ngkz/E490-VRM-Fan-Controller/vrmfanctl_pcb/vrmfanctl_pcb.kicad_pcb

## KiCad design vrmfanctl_pcb/vrmfanctl_pcb.kicad_pcb (2019-10-17)

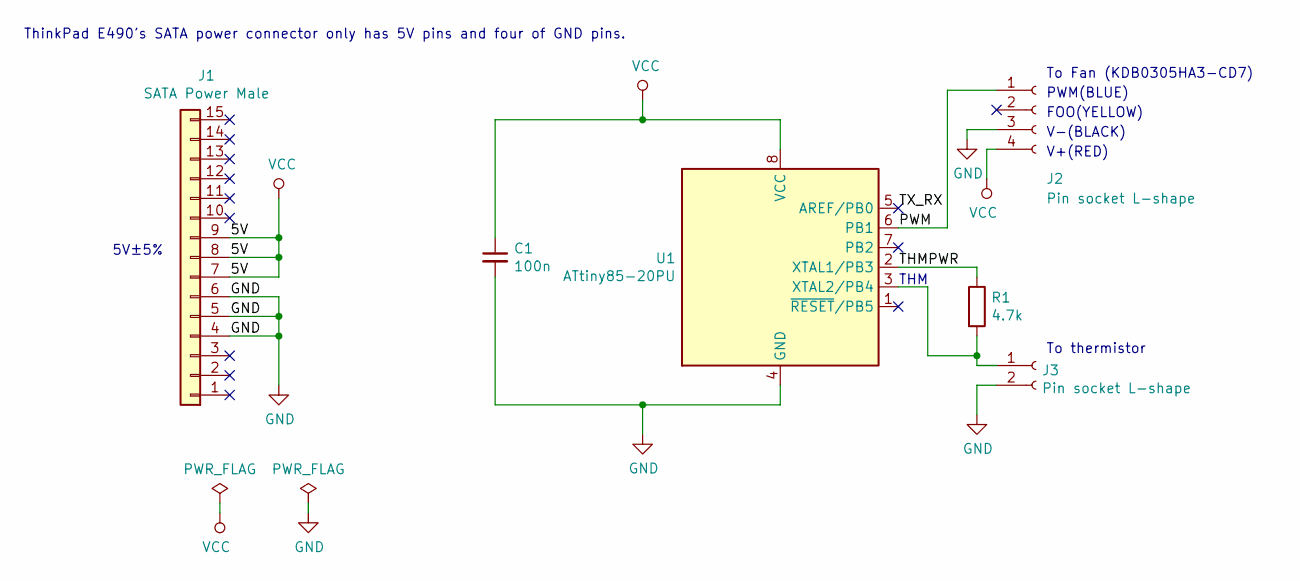
[picture p1: schematic vrmfanctl_pcb.sch]

Parts:
C1: 100n; C_Disc_D5.0mm_W2.5mm_P2.50mm
J1: SATA Power Male; SATA_Power_PCBEdge
J2: Pin socket L-shape; PinSocket_1x04_P2.54mm_Horizontal
J3: Pin socket L-shape; PinSocket_1x02_P2.54mm_Horizontal
R1: 4.7k; R_Axial_DIN0204_L3.6mm_D1.6mm_P5.08mm_Horizontal
U1: ATtiny85-20PU; DIP-8_W7.62mm

Connections:
/PWM: J2.1, U1.6 (PB1)
/THMPWR: R1.1, U1.2 (XTAL1/PB3)
/TX_RX: U1.5 (AREF/PB0)
GND: C1.2, J1.4, J1.5, J1.6, J2.3, J3.2, U1.4 (GND)
unnamed: J3.1, R1.2, U1.3 (XTAL2/PB4)
VCC: C1.1, J1.7, J1.8, J1.9, J2.4, U1.8 (VCC)

Notes on the sheet:
ThinkPad E490's SATA power connector only has 5V pins and four of GND pins.
PWM(BLUE)
FOO(YELLOW)
V-(BLACK)
V+(RED)
To Fan (KDB0305HA3-CD7)
5V±5%
To thermistor
THM

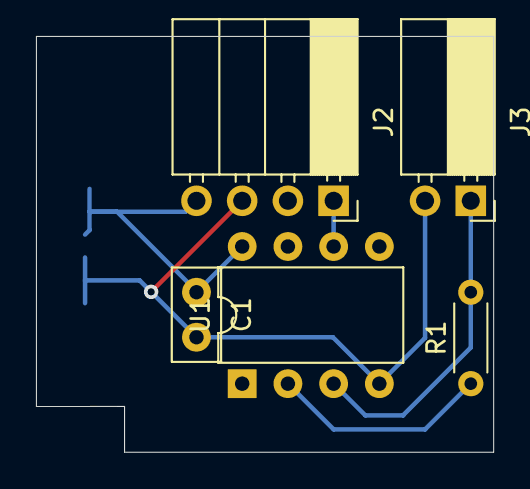
[picture p2: board vrmfanctl_pcb.kicad_pcb from above]

Board: 2 copper layers, 25.4 x 23.1 mm, 6 parts (1 on the bottom side), 5 nets.
