ngkz/E490-VRM-Fan-Controller/firmware/src/fan.c

/*
 *  ThinkPad E490 VRM Cooling Mod Controller Firmware
 *  Copyright (C) 2019  Kazutoshi Noguchi
 *
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
 *  You should have received a copy of the GNU General Public License
 *  along with this program.  If not, see <https://www.gnu.org/licenses/>.
 */

#include <avr/io.h>
#include <avr/power.h>
#include "fan.h"

#define P_PWM        PB1 //OC1A

void init_fan(void) {
    DDRB |= _BV(P_PWM);   // PWM out
    PORTB &= ~_BV(P_PWM); // PWM low

#if P_PWM != PB1 || F_CPU != 1000000L
#error "update timer 1 configuration"
#endif

    // timer 1 configuration
    // no clear on compare match, turn on PWM A, disconnect timer comparator A from the output pin, stop the clock
    TCCR1 = _BV(PWM1A);
    // turn off PWM B, disconnect PWM B from the output pin, no force output compare match, no timer 1 prescaler reset
    GTCCR &= ~(_BV(PWM1B) | _BV(COM1B1) | _BV(COM1B0) | _BV(FOC1B) | _BV(FOC1A) | _BV(PSR1));
    // reset the counter
    TCNT1 = 0;
    // reset output compare registers
    OCR1A = 0;
    OCR1B = 0;
    // PWM freqency 1MHz(Timer 1 clock) / (39 + 1) = 25kHz, setFanDuty() configures the clock.
    OCR1C = 39;
    // disable all Timer1 interrupts
    TIMSK &= ~(_BV(OCIE1A) | _BV(OCIE1B) | _BV(TOIE1));
    // clear the Timer1 interrupt flags
    TIFR |= _BV(OCF1A) | _BV(OCF1B) | _BV(TOV1);

    power_timer1_disable();
}

//duty: 0-OCR1C
void set_fan_duty(uint8_t duty) {
    if (duty > 0 && duty < OCR1C) {
        // start PWM
        power_timer1_enable();
        // set the duty
        OCR1A = duty;
        // reset the counter
        TCNT1 = 0;
        // reset timer 1 prescaler
        GTCCR |= _BV(PSR1);
        // connect PWM A to OC1A,  start timer 1, 1MHz clock
        TCCR1 |= _BV(COM1A1) | _BV(CS10);
    } else {
        // stop PWM
        // disconnect PWM A from OC1A stop timer 1
        TCCR1 &= ~(_BV(COM1A1) | _BV(COM1A0) | _BV(CS13) | _BV(CS12) | _BV(CS11) | _BV(CS10));
        power_timer1_disable();

        PORTB = (PORTB & ~_BV(P_PWM)) | (duty == 0 ? 0 : _BV(P_PWM));
    }
}
