ngkz/E490-VRM-Fan-Controller/(commit log)

2019-07-26 reduce power consumption
2019-07-26 disable timer1 and timer0 at startup
2019-07-29 pwm control
2019-07-29 fuse comment
2019-07-30 configure Timer0 as a counter
2019-07-30 measure fan rotation speed
2019-08-09 Add PCB and License file
    [vrmfanctl_pcb.kicad_pcb, vrmfanctl_pcb.sch]
2019-08-09 forgot to wire FG
    [vrmfanctl_pcb.kicad_pcb]
2019-08-09 Use OC1A instead of OC1B. OC1B PWM output of ATTiny85 has a problem the same as ATTiny45 Rev B-C.
    [vrmfanctl_pcb.kicad_pcb, vrmfanctl_pcb.sch]
2019-08-09 turn off timer 1 when duty is 255
2019-08-09 return 0RPM if no FG signal over 1 second.
2019-08-19 supply 3.3V with M.2 SSD
    [vrmfanctl_pcb.kicad_pcb, vrmfanctl_pcb.sch]
2019-08-21 Add a UART header. remove an I2C interface. Add a temperature sensor.
    [vrmfanctl_pcb.kicad_pcb, vrmfanctl_pcb.sch]
2019-08-21 Use through hole instead of pin header
    [vrmfanctl_pcb.kicad_pcb, vrmfanctl_pcb.sch]
2019-08-24 remove unneeded FG wire
    [vrmfanctl_pcb.kicad_pcb, vrmfanctl_pcb.sch]
2019-08-25 add reset pin to the header
    [vrmfanctl_pcb.kicad_pcb, vrmfanctl_pcb.sch]
2019-09-06 rewrite firmware and update pcb
    [vrmfanctl_pcb.kicad_pcb, vrmfanctl_pcb.sch]
2019-09-06 extract fan control loop
2019-09-20 RX pin configuration was wrong
    [uart.c]
2019-09-20 fix a bug that the same register is allocated to ch and count.
    [uart.c]
2019-09-21 prevent that the optimization breaks software uart
    [uart.c]
2019-09-21 Set fuses using platformio. Preserve EEPROM through the Cip Erase cycle. update README.
2019-09-21 make magic numbers macro. handle backspace correctly. send bell if the line buffer is full
    [uart.c]
2019-09-21 shorten trace output because UART is slow. increase baud rate. fix wrong timer 0 prescaler config.
    [uart.c]
2019-09-22 Fix integer overflow and underflow. ADC_VALUE_TO_VOLTAGE() -> adc_value_to_mv()
    [thermometer.c, thermometer.h]
2019-09-22 make calibrate command cancellable
2019-09-22 round adc_value_to_mv(voltage)
2019-09-24 add workaround for ATTiny85 Timer Errata
    [fan.c]
2019-09-26 change pcb layout
    [vrmfanctl_pcb.kicad_pcb, vrmfanctl_pcb.sch]
2019-09-28 Stop using asynchronous timer because PLL consumes a lot of power. Increase system clock to 250kHz.
2019-09-28 improve trace output
2019-09-28 increase uart baud rate
2019-09-28 fix wrong fan duty range
    [fan.c]
2019-09-28 show fan speed when testing fan
2019-09-29 change fan control algorithm
2019-10-02 change temperature measurement method. remove configuration interface. use printf instead of put*.
    [vrmfanctl_pcb.kicad_pcb, vrmfanctl_pcb.sch]
2019-10-03 trace thermometer
2019-10-03 change fan control table
2019-10-03 simplify fan control algorithm
2019-10-04 change fan control threshold
2019-10-06 swap BDPWR10 and TX. Add UART pin header
    [vrmfanctl_pcb.kicad_pcb, vrmfanctl_pcb.sch]
2019-10-06 make uart half-duplex
2019-10-07 fix uart clock
2019-10-07 fix wrong ELEMENTARY_CHANGE constant value
    [thermometer.c]
2019-10-07 convert temperature to celcius degree
2019-10-08 keep analog signals from digital signals
    [vrmfanctl_pcb.kicad_pcb, vrmfanctl_pcb.sch]
2019-10-08 enter adc noise reduction mode when a/d conversion
    [main.c, thermometer.c]
2019-10-08 swap PB2 and PB0
    [vrmfanctl_pcb.kicad_pcb, vrmfanctl_pcb.sch]
2019-10-08 adc(): sample more
2019-10-14 use thermistor instead of thermal diode
    [vrmfanctl_pcb.sch]
2019-10-14 calibrate adc. more accurate R1.
2019-10-15 remove bootloader. stop disabling reset pin. patch board definition with platformio.ini
2019-10-15 remove debug ui. allow call TRACE() with one argument. increase system clock to 1MHz. remove oscillator calibration code. revert fan control algorithm. enter power-down mode if fan stopped. use wdt t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
    [debug.h, fan.c, main.c, thermometer.c, thermometer.h, uart.c, uart.h]
2019-10-15 update pcb layout
    [vrmfanctl_pcb.kicad_pcb, vrmfanctl_pcb.sch]
2019-10-17 update thermistor config. change R1 resistor to 4.7K.
    [vrmfanctl_pcb.kicad_pcb, vrmfanctl_pcb.sch]
2019-10-17 change fan stop timing
2019-10-17 change trace timing
2019-10-19 take less samples when a/d conversion
2019-10-19 limit range of adc result
2019-10-19 prevent that measure_temp() return NaN if the thermistor is not connected
    [thermometer.c]
2019-10-19 change fan control parameter
