ngkz/E490-VRM-Fan-Controller/(notices)

Notices in the files:
firmware/src/thermometer.c:
This program is free software: you can redistribute it and/or modify
it under the terms of the GNU General Public License as published by
the Free Software Foundation, either version 3 of the License, or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
firmware/src/uart.c:
Copyright (c) 2006 Nicholas Zambetti. All right reserved.
